lukewakeford/midi-loop-switcher/v3BOM.csv

ID | Name | Designator | Footprint | Quantity | Manufacturer Part | Manufacturer | Supplier | Supplier Part | Price | Pins | 3DModel | Contributor | JLCPCB Part Class | Package Display | link
1 | MINI5605V5A输出电源模块 | MINI560 | COMM-SMD_MINI560PRO-HEADERS | 1 | mini5605V5A输出电源模块 | null | LCSC | C9900015474 |  | 8 |  | lcsc | Extended Part |  | https://img.jlc.com/pdf/applyPasteComponent/2023-10-27/562764A/da1a0c2328bb44b08f5a269660186d03/Mini560PRO%E6%95%B0%E6%8D%AE%E6%89%8B%E5%86%8C.pdf
2 | ESP32 C3 SuperMini | U7 | ESP32-C3-SUPERMINI | 1 |  |  |  |  |  | 16 | ESP32-C3 supermini v5 | luke2 |  | No
3 | PN2222AL | U1,U2,U3,U4 | TO-92-3_L4.8-W3.7-P2.54-L | 4 | PN2222AL | UTC(友顺) | LCSC | C7509661 | 0.033 | 3 | TO-92-3_L4.8-W3.7-H4.8-P2.54 | lcsc |  |  | https://item.szlcsc.com/269152.html
4 | MHL3014GTD | LED1,LED2,LED3,LED4 | LED-TH_BD3.9-P2.54-RD_GREEN | 4 | MHL3014GTD | MEIHUA(美华) | LCSC | C3028821 | 0.032 | 2 | LED-TH_BD3.9-P2.54-RD_GREEN | lcsc | Extended Part |  | https://atta.szlcsc.com/upload/public/pdf/source/20210928/6840B39F36C3FDD0AC56C6B66B0665C0.pdf
5 | 220Ω | R9,R10,R11,R12,R7,R8,R5 | RES-TH_BD2.3-L6.5-P10.50-D0.5 | 7 | CF1/4W-220Ω±5% T | CCO(千志电子) | LCSC | C120039 | 0.005 | 2 | RES-TH_D2.3-L6.5-P10.50 | LCSC | Extended Part |  | https://item.szlcsc.com/123457.html
6 | TYPE A | MIDOUT,MIDIIN | AUDIO-TH_PJ-313_5JCJ | 2 | PJ-313 5JCJ | SHOU HAN(首韩) | LCSC | C668607 | 0.081 | 5 | AUDIO-TH_PJ-313_5JCJ | LCSC | Extended Part |  | https://atta.szlcsc.com/upload/public/pdf/source/20200618/C668607_FE17687B176711313D54B567644D1F03.pdf
7 | 1kΩ | R1,R2,R3,R4,R6 | RES-TH_BD2.3-L6.5-P10.50-D0.5 | 5 | MF1/4W-1KΩ±1%T52 | 华星机电 | LCSC | C713997 | 0.006 | 2 | RES-TH_D2.3-L6.5-P10.50 | LCSC | Extended Part |  | https://item.szlcsc.com/123457.html
8 | DC-005-2.5A-2.0 | DC1 | CONN-TH_DC-005-2.5A-2.0 | 1 | DC-005-2.5A-2.0 | XKB Connectivity(中国星坤) | LCSC | C319099 | 0.079 | 3 | DC-IN-TH_L14.2-W8.8-H10.8 | LCSC | Extended Part |  | https://item.szlcsc.com/300191.html
9 | 1N4004_C402210 | D2,D1,D3,D4,D5 | DO-41_BD2.4-L4.7-P8.70-D0.9-RD | 5 | 1N4004 | LGE(鲁光) | LCSC | C402210 | 0.013 | 2 | DO-41_D2.4-L4.7-P8.70 | LCSC | Extended Part |  | https://item.szlcsc.com/85412.html
10 | PJ-609BA | INPUT,OUTPUT | AUDIO-TH_PJ-609BA | 2 | PJ-609BA | HOOYA(皓宇电子) | LCSC | C309277 | 0.481 | 6 | AUDIO-TH_PJ-609BA | LCSC | Extended Part |  | https://item.szlcsc.com/292938.html
11 | G5V-2-H1-5V | K1,K2,K3,K4 | RELAY-TH_G5V-2 | 4 | G5V-2-H1 DC5 | OMRON(欧姆龙) | LCSC | C28066 | 1.178 | 8 | RELAY-TH_G5V-2 | 立创EDA官方封装库 | Extended Part |  | https://item.szlcsc.com/231265.html
12 | PEDJCJ | PEDAL1,PEDAL2,PEDAL3,PEDAL4 | AUDIO-TH_PJ-313_5JCJ | 4 | PJ-313 5JCJ | SHOU HAN(首韩) | LCSC | C668607 | 0.081 | 5 | AUDIO-TH_PJ-313_5JCJ | LCSC | Extended Part |  | https://atta.szlcsc.com/upload/public/pdf/source/20200618/C668607_FE17687B176711313D54B567644D1F03.pdf
13 | 6N137_C142297 | U5 | DIP-8_L9.8-W6.6-P2.54-LS7.6-BL | 1 | 6N137 | EVERLIGHT(亿光) | LCSC | C142297 | 0.258 | 8 | DIP-8_L9.8-W6.6-H3.5-LS7.62-P2.54 | LCSC | Extended Part |  | https://item.szlcsc.com/47753.html
