lukewakeford/midi-loop-switcher/(commit log)

2024-02-18 adds gerber for current pcb
2024-07-26 Updates v1.0 readme, layout, bom removes gerber.
    [v1BOM.csv]
2024-07-26 Updates for esp32 c3
2024-07-26 removes serial prints
2024-07-26 Adds BLEMidi forwarding and LED control
2024-07-26 Updates readme, BOM and Layout for v3
    [v1BOM.csv, v3BOM.csv]
2024-07-30 Disables hardware midi thru to avoid clashing
    [midi-loop-switcher.ino]
2025-01-06 Updates BOM and adds gerber
    [v3BOM.csv]
